ftobler/bldc-high-current/pcb/bldc-high-current-2-easyeda/release/BOM_Board1_PCB1_2025-11-01.xlsx

No. | Quantity | Comment | Designator | Footprint | Value | Manufacturer Part | Manufacturer | Supplier Part | Supplier
1 | 5 | 1nF | C4,C43,C116,C117,C126 | C0402 | 1nF | 0402B102K500NT | FH(风华) | C1523 | LCSC
2 | 5 | 10uF | C9,C96,C97,C98,C100 | C1206 | 10uF | CL31A106KBHNNNE | SAMSUNG(三星) | C13585 | LCSC
3 | 2 | 10pF | C46,C47 | C0402 | 10pF | CL05C100JB5NNNC | SAMSUNG(三星) | C32949 | LCSC
4 | 2 | 68pF | C54,C109 | C0603 | 68pF | 0603CG680J500NT | FH(风华) | C1680 | LCSC
5 | 2 | 47uF | C55,C107 | C0805 | 47uF | CL21A476MQYNNNE | SAMSUNG(三星) | C16780 | LCSC
6 | 4 | 470uF | C110,C111,C112,C113 | CAP-SMD_BD10.0-L10.3-W10.3-FD | 470uF | RVT1V471M1010 | HONOR(荣誉) | C3350 | LCSC
7 | 8 | 10uF | C118,C119,C120,C121,C122,C123,C124,C125 | C0805 | 10uF | CL21A106KAYNNNE | SAMSUNG(三星) | C15850 | LCSC
8 | 23 | 100nF | C137,C138,C139,C143,C144,C145,C146,C147,C148,C151,C152,C153,C154,C155,C156,C157,C158,C159,C160,C161,C162,C163,C164 | C0402 | 100nF | CL05B104KB54PNC | SAMSUNG(三星) | C307331 | LCSC
9 | 1 | SMBJ24CA | D1 | SMB_L4.6-W3.6-LS5.3-BI |  | SMBJ24CA | Brightking(君耀电子) | C78416 | LCSC
10 | 5 | SS14 | D3,D4,D5,D6,D7 | SMA_L4.2-W2.6-LS5.0-RD_1 |  | SS14 | MDD(辰达半导体) | C2480 | LCSC
11 | 5 | T34080080-0680 | J1,J2,J3,J4,J5 | CONN-TH_T34080080-0680 |  | T34080080-0680 | XFCN(兴飞) | C19724524 | LCSC
12 | 2 | B3B-XH-AM-BK(LF)(SN) | J6,J7 | CONN-TH_B3B-XH-AM-BK-LF-SN |  | B3B-XH-AM-BK(LF)(SN) | JST | C565985 | LCSC
13 | 1 | 12uH | L1 | IND-SMD_L6.0-W6.0_SWPA6045S | 12uH | SWPA6045S120MT | Sunlord(顺络) | C96951 | LCSC
14 | 1 | 6.8uH | L2 | IND-SMD_L5.0-W5.0_SWPA5040S | 6.8uH | SWPA5040S6R8MT | Sunlord(顺络) | C36411 | LCSC
15 | 18 | KT-0603R | LED1,LED2,LED3,LED4,LED5,LED6,LED7,LED8,LED9,LED10,LED11,LED12,LED13,LED14,LED15,LED16,LED17,LED18 | LED0603-RD |  | KT-0603R | KENTO | C2286 | LCSC
16 | 7 | DOD100N04 | Q1,Q2,Q7,Q8,Q9,Q10,Q12 | TO-252-2_L6.6-W6.2-P4.57-LS10.1-BR-CW |  | DOD100N04 | DOINGTER(杜因特) | C42374600 | LCSC
17 | 3 | 2mΩ | R1,R47,R54 | RES-SMD_L6.4-W3.2-1 | 2mΩ | HoLLR2512-3W-2mR-1% | Milliohm(毫欧) | C2994640 | LCSC
18 | 6 | 100kΩ | R5,R6,R44,R45,R51,R52 | R0603 | 100kΩ | 0603WAF1003T5E | UNI-ROYAL(厚声) | C25803 | LCSC
19 | 2 | 2.7kΩ | R31,R91 | R0603 | 2.7kΩ | 0603WAF2701T5E | UNI-ROYAL(厚声) | C13167 | LCSC
20 | 2 | 51kΩ | R39,R92 | R0402 | 51kΩ | 0402WGF5102TCE | UNI-ROYAL(厚声) | C25794 | LCSC
21 | 2 | 10Ω | R69,R70 | RES-TH_BD8.0-L24.5-P28.50-D0.8 | 10Ω | KNP5W-10Ω±5% T | CCO(千志电子) | C136506 | LCSC
22 | 7 | 20Ω | R71,R72,R73,R74,R75,R76,R77 | R0805 | 20Ω | 0805W8F200JT5E | UNI-ROYAL(厚声) | C17544 | LCSC
23 | 5 | 15kΩ | R80,R99,R100,R101,R116 | R0402 | 15kΩ | 0402WGF1502TCE | UNI-ROYAL(厚声) | C25756 | LCSC
24 | 37 | 3.3kΩ | R81,R85,R86,R87,R88,R89,R90,R93,R94,R95,R96,R97,R98,R102,R103,R104,R105,R106,R107,R108,R109,R110,R111,R112,R113,R114,R115,R117,R118,R119,R120,R121,R122,R123,R124,R125,R126 | R0402 | 3.3kΩ | 0402WGF3301TCE | UNI-ROYAL(厚声) | C25890 | LCSC
25 | 3 | 10MΩ | R82,R83,R84 | R0603 | 10MΩ | 0603WAF1005T5E | UNI-ROYAL(厚声) | C7250 | LCSC
26 | 3 | TLV9061IDBVR | U2,U23,U26 | SOT-23-5_L3.0-W1.7-P0.95-LS2.8-BL |  | TLV9061IDBVR | TI(德州仪器) | C398358 | LCSC
27 | 1 | AS5600-ASOM | U5 | SOIC-8_L5.0-W4.0-P1.27-LS6.0-BL |  | AS5600-ASOM | ams(艾迈斯半导体) | C79815 | LCSC
28 | 2 | SP3485EN-L/TR | U6,U7 | SOIC-8_L5.0-W4.0-P1.27-LS6.0-BL |  | SP3485EN-L/TR | MaxLinear(迈凌) | C8963 | LCSC
29 | 2 | TPS54302DDCT | U12,U29 | TSOT-23-6_L2.9-W1.6-P0.95-LS2.8-BR |  | TPS54302DDCT | TI(德州仪器) | C129370 | LCSC
30 | 1 | STM32G474RBT6 | U15 | LQFP-64_L10.0-W10.0-P0.50-LS12.0-BL |  | STM32G474RBT6 | ST(意法半导体) | C529413 | LCSC
31 | 1 | M24C64-RMN6TP | U16 | SOIC-8_L5.0-W4.0-P1.27-LS6.0-BL |  | M24C64-RMN6TP | ST(意法半导体) | C79988 | LCSC
32 | 4 | LKS523 | U20,U22,U25,U28 | SOP-8_L4.9-W3.9-P1.27-LS6.0-BL |  | LKS523 | LINKOSEMI(凌鸥创芯) | C6337451 | LCSC
33 | 1 | 25MHz | X1 | CRYSTAL-SMD_4P-L3.2-W2.5-BL | 25MHz | X322525MOB4SI | YXC(扬兴晶振) | C9006 | LCSC
