ftobler/bldc-high-current/pcb/bldc-high-current-2-easyeda/bldc-high-current-2-easyeda.pdf

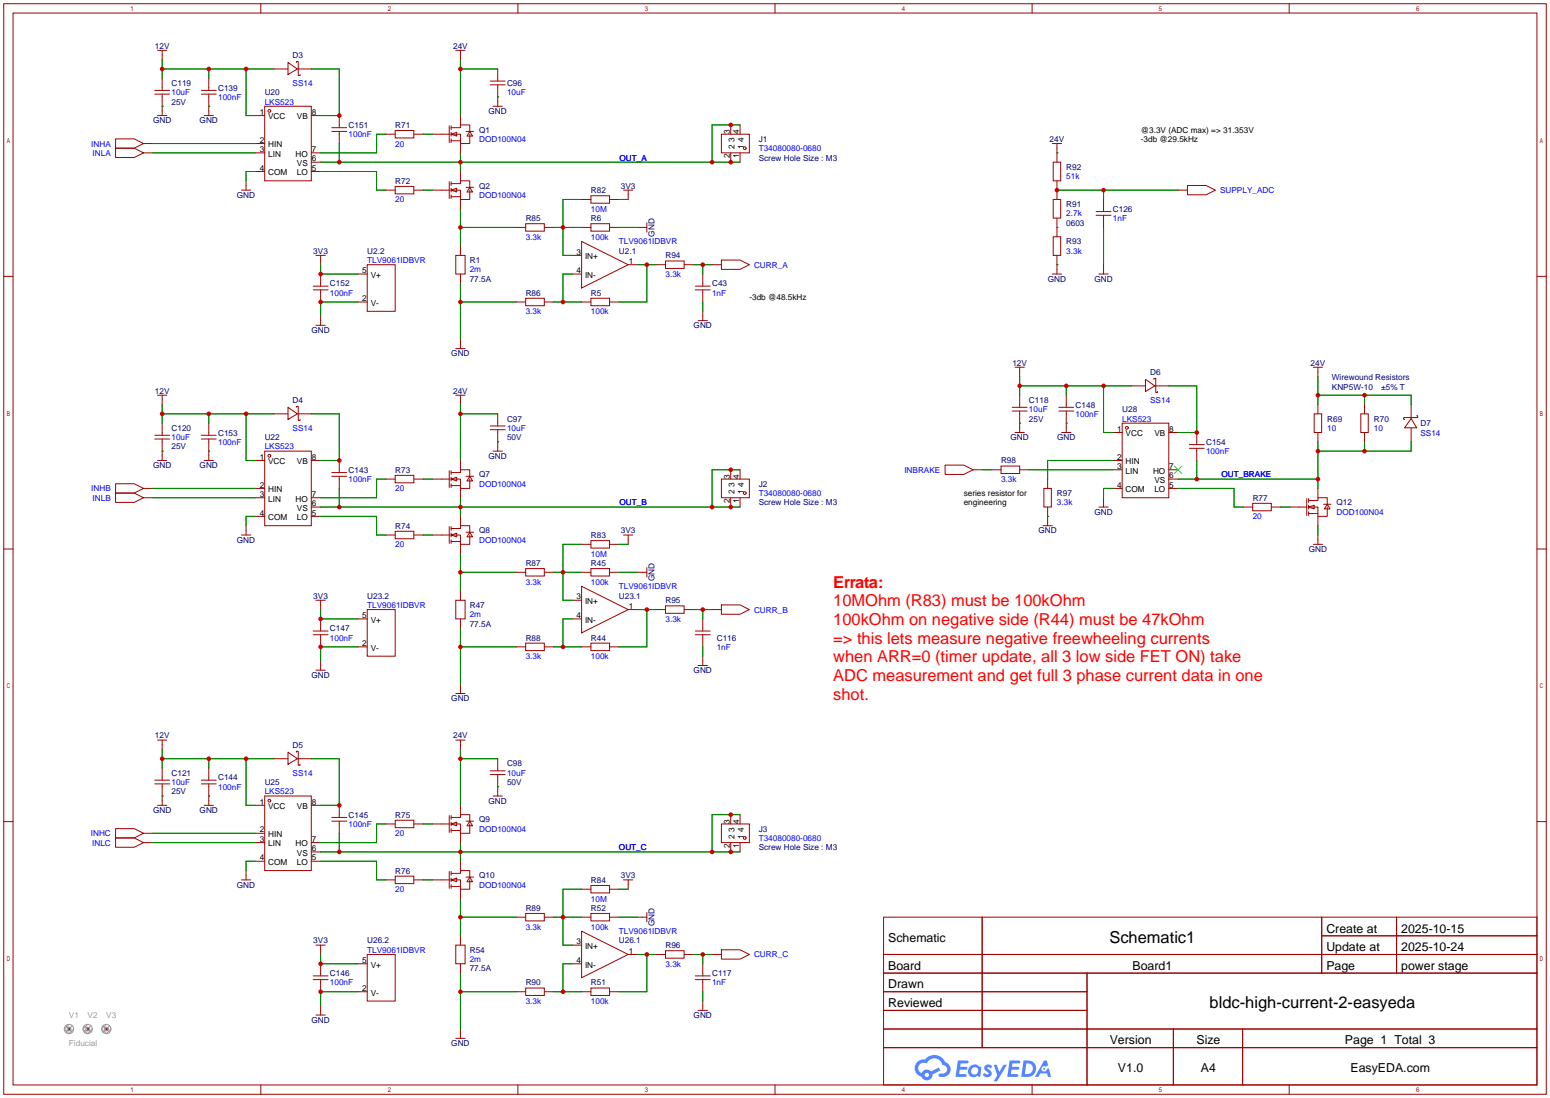
[picture p1: page 1]

Errata:
10MOhm (R83) must be 100kOhm
100kOhm on negative side (R44) must be 47kOhm
=> this lets measure negative freewheeling currents
when ARR=0 (timer update, all 3 low side FET ON) take
ADC measurement and get full 3 phase current data in one
shot.

Schematic | Schematic1 | Create at | 2025-10-15

Update at | 2025-10-24

Board | Board1 | Page | power stage
Drawn | | bldc-high-current-2-easyeda
Reviewed

Version | Size | Page 1 Total 3
V1.0 | A4 | EasyEDA.com

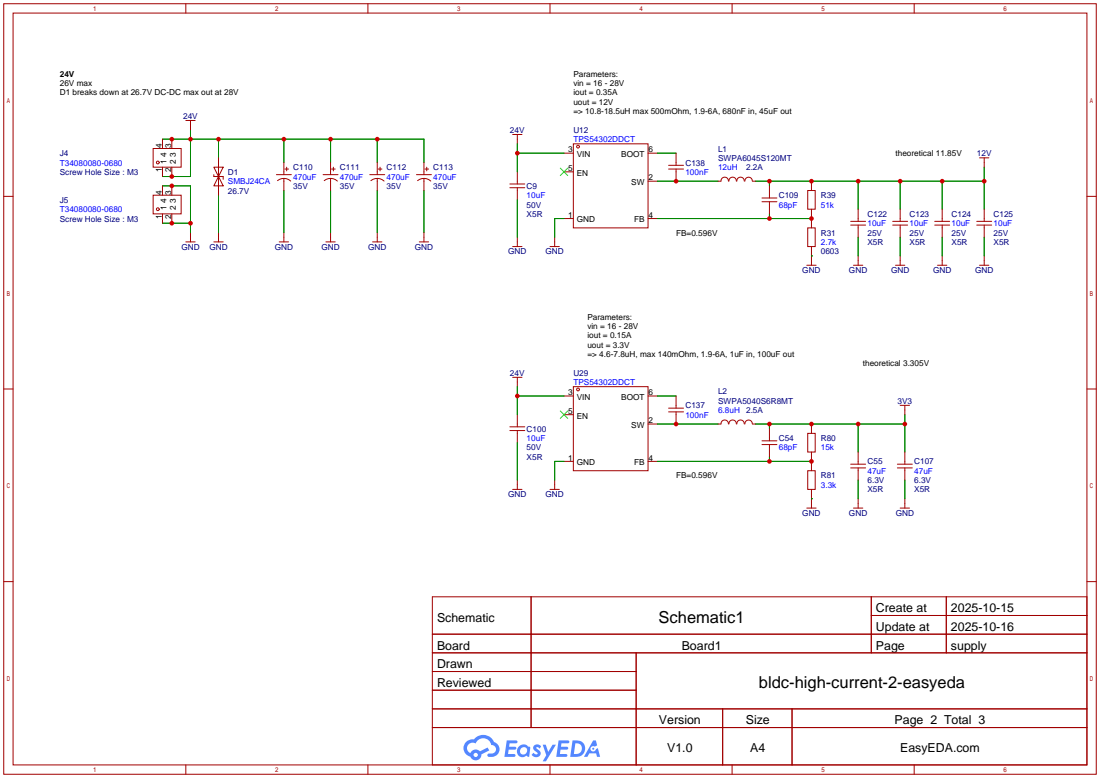
[picture p2: page 2]

26V max
D1 breaks down at 26.7V DC-DC max out at 28V

Schematic | Schematic1 | Create at | 2025-10-15

Update at | 2025-10-16

Board | Board1 | Page | supply
Drawn | | bldc-high-current-2-easyeda
Reviewed

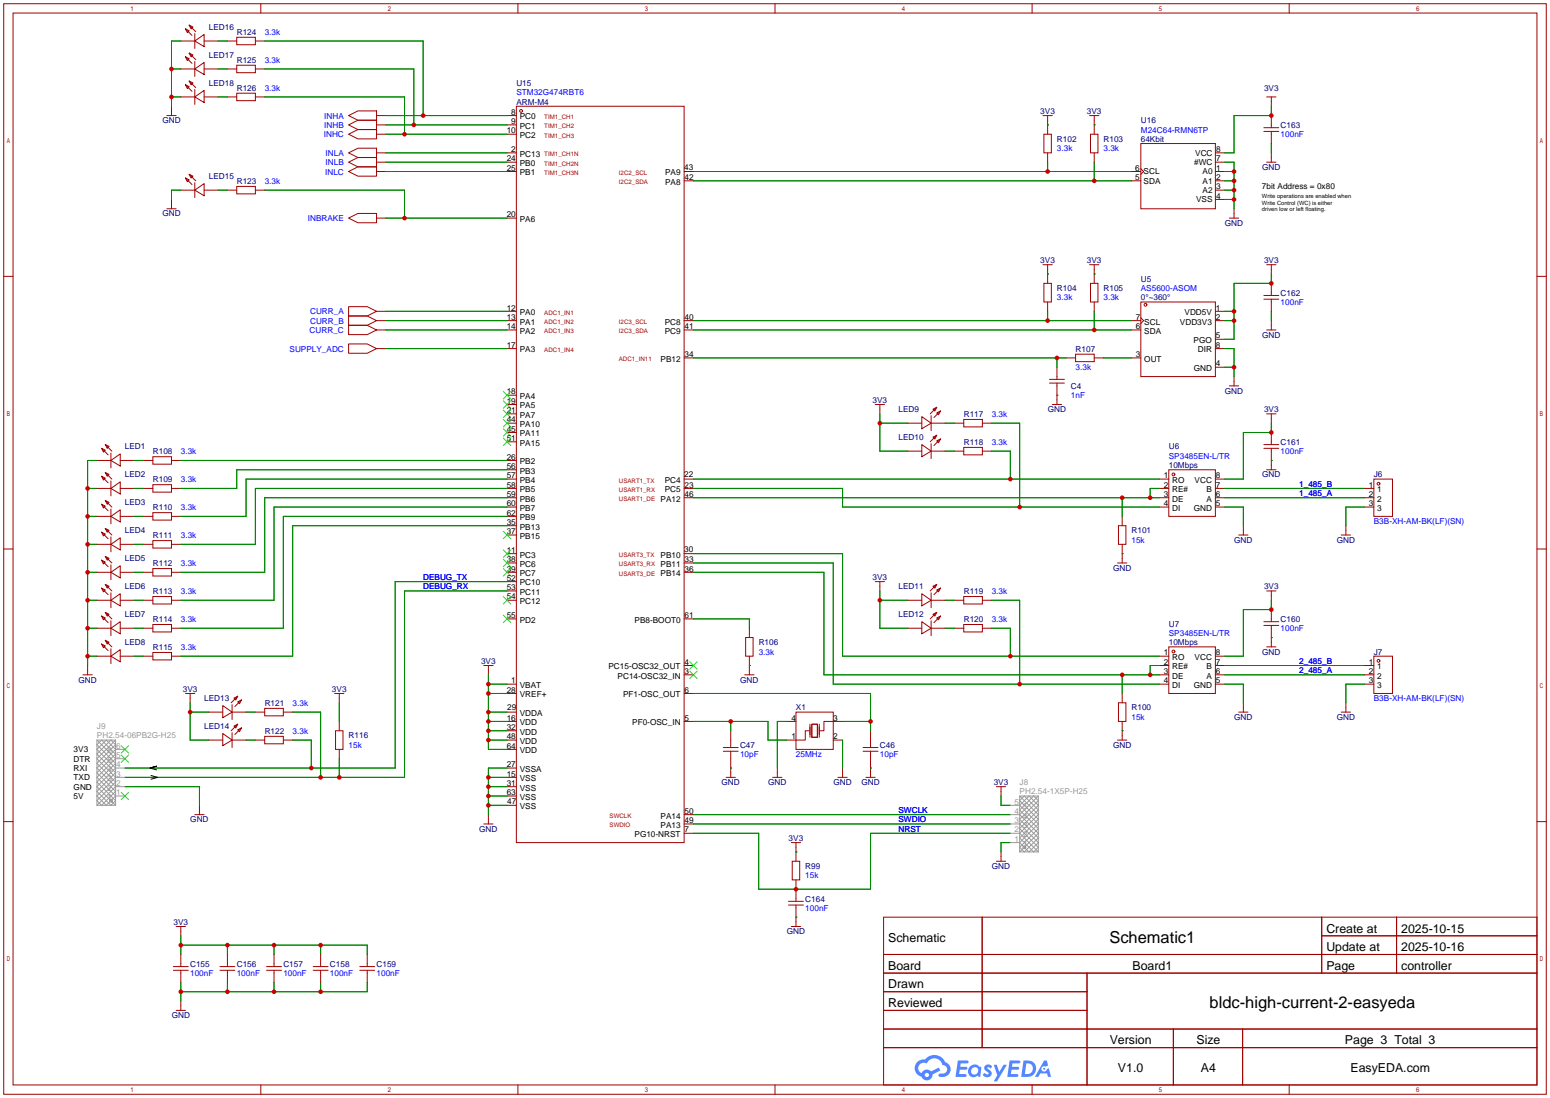
[picture p3: page 3]

GND
7bit Address = 0x80
Write operations are enabled when
Write Control (WC) is either
driven low or left floating.

Schematic | Schematic1 | Create at | 2025-10-15

Update at | 2025-10-16

Board | Board1 | Page | controller
Drawn | | bldc-high-current-2-easyeda
Reviewed
