ftobler/bldc-high-current/(list of files, drawings)

Other design files:
pcb/bldc-high-current-2-easyeda/bldc-high-current-2-easyeda.epro
