ftobler/bldc-high-current/stm-bldc-high-current/stm-bldc-high-current.ioc

Mcu.UserName=STM32G474RBTx
PA0.Signal=ADC1_IN1
PA1.Signal=ADC1_IN2
PA12.Signal=USART1_DE
PA13.Signal=SYS_JTMS-SWDIO
PA14.Signal=SYS_JTCK-SWCLK
PA2.Signal=ADC1_IN3
PA3.Signal=ADC1_IN4
PA6.Signal=S_TIM3_CH1
PA8.Signal=I2C2_SDA
PA9.Signal=I2C2_SCL
PB0.Signal=TIM1_CH2N
PB1.Signal=TIM1_CH3N
PB10.Signal=USART3_TX
PB11.Signal=USART3_RX
PB12.Signal=ADC1_IN11
PB13.GPIO_Label=LED8
PB13.Signal=GPIO_Output
PB14.Signal=USART3_DE
PB2.GPIO_Label=LED1
PB2.Signal=GPIO_Output
PB3.GPIO_Label=LED2
PB3.Signal=GPIO_Output
PB4.GPIO_Label=LED3
PB4.Signal=GPIO_Output
PB5.GPIO_Label=LED4
PB5.Signal=GPIO_Output
PB6.GPIO_Label=LED5
PB6.Signal=GPIO_Output
PB7.GPIO_Label=LED6
PB7.Signal=GPIO_Output
PB9.GPIO_Label=LED7
PB9.Signal=GPIO_Output
PC0.Signal=S_TIM1_CH1
PC1.Signal=S_TIM1_CH2
PC10.Signal=UART4_TX
PC11.Signal=UART4_RX
PC13.Signal=TIM1_CH1N
PC2.Signal=S_TIM1_CH3
PC4.Signal=USART1_TX
PC5.Signal=USART1_RX
PC8.Signal=I2C3_SCL
PC9.Signal=I2C3_SDA
PF0-OSC_IN.Signal=RCC_OSC_IN
PF1-OSC_OUT.Signal=RCC_OSC_OUT
