ftobler/bldc-high-current/stm-bldc-high-current/Core/Inc/main.h

#define LED1_Pin GPIO_PIN_2
#define LED1_GPIO_Port GPIOB
#define LED8_Pin GPIO_PIN_13
#define LED8_GPIO_Port GPIOB
#define LED2_Pin GPIO_PIN_3
#define LED2_GPIO_Port GPIOB
#define LED3_Pin GPIO_PIN_4
#define LED3_GPIO_Port GPIOB
#define LED4_Pin GPIO_PIN_5
#define LED4_GPIO_Port GPIOB
#define LED5_Pin GPIO_PIN_6
#define LED5_GPIO_Port GPIOB
#define LED6_Pin GPIO_PIN_7
#define LED6_GPIO_Port GPIOB
#define LED7_Pin GPIO_PIN_9
#define LED7_GPIO_Port GPIOB
