ftobler/bldc-high-current/stm-bldc-high-current/application/motor.h

/*
 * bldc.h
 *
 *  Created on: Nov 1, 2025
 *      Author: ftobler
 */

#pragma once

#include "stm32_hal.h"
#include "calibration.h"
#include "foc.h"
//#include "speed_control.h"
//#include "position_control.h"
#include "controller.h"
#include "speedometer.h"
#include "shaper.h"
#include "lqi.h"


 struct  __attribute__((packed)) Adc_dma {
    uint16_t current_a;
    uint16_t current_b;
    uint16_t current_c;
    uint16_t supply;
};

static_assert(sizeof(Adc_dma) == 8);  // if false, compiler is set up wrong


class Motor {
private:
    enum class Mode : uint8_t {
        off,               // safe off
        manual,            // direct set of angle/power from user or debug
        calibration,       // static PWM stepping for encoder alignment
        power_control,     // sets angle automatic +90deg or -90deg
        current_control,   // inner FOC or current loop active
        speed_control,     // speed control on top of foc
        position_control,  // positoin control on top of speed
        shaped_position,   // positoin control with slope limit
        lqi_position       // LQI (Linear Quadratic Integrator)
    };
    enum class StopReason {
        none,
        pwm,
        current,
        success,
    };

    static constexpr uint32_t timer_psc = 0;
    static constexpr uint32_t mcu_frequency = 170000000;
    static constexpr uint32_t pwm_frequency = 25000;
    static constexpr uint32_t timer_arr = mcu_frequency / pwm_frequency / 2;  // div 2 is because we are using center aligned mode

    static constexpr int pole_pairs = 5;

    TIM_HandleTypeDef& timer;
    ADC_HandleTypeDef& adc;
    Adc_dma adc_buffer = {0};

    // at startup, the first sample is to calibrate 0A point
    int16_t current_a_zero_offset = 0;
    int16_t current_b_zero_offset = 0;
    int16_t current_c_zero_offset = 0;

    // runtime control variables
    bool pwm_on = false;
    float power = 0.0f;
    float angle = 0.0f;
    float angle_increment = 0.0f;
    Mode state = Mode::off;
    Mode old_state = Mode::off;
    StopReason stop_reason = StopReason::none;

    // calculated phase currents
    float current_a = 0.0f;
    float current_b = 0.0f;
    float current_c = 0.0f;
    float supply_voltage = 0.0f;

    float current_a_tpfilter = 0.0f;
    float current_b_tpfilter = 0.0f;
    float current_c_tpfilter = 0.0f;
    int32_t encoder_value = 0;  // current angle 12bit
    int32_t encoder_offset = 2043;  // from a calibration

    Calibration calibration;
    Foc foc;
    Speedometer speedometer;
    Controller speed;
    Controller position;
    Shaper shaper;
    LqiController lqi;

//    Speed speed;
//    Position position;

    inline void assign_pwm(float power, float angle);
    inline void assign_pwm_volt(float sa, float sb, float sc);
    inline void assign_stop();
    inline void setup_timer();
    inline void setup_adc();
    inline float calculate_supply_voltage(uint16_t sample);
    inline float calculate_adc_current(int16_t sample);
    inline void adc_calculate();
    inline void current_kirchhoff_reconstruct(float a, float b, float c);
    inline void calibrate_adc();
    inline void run_calibration_step();
    inline void run_power_control();
    inline void run_current_control();
    inline void run_speed_control();
    inline void run_position_control();
    inline void run_position_shaped_control();
    inline void run_lqi_control();
    inline void pwm_safe_assign(Vector3& v);

    static constexpr float update_time = 1 / 24000.0f;
public:
    Motor(
            TIM_HandleTypeDef& timer,
            ADC_HandleTypeDef& adc
    ):
        timer(timer),
        adc(adc),
        speedometer(update_time),
        // position(0.0075f, 0.000, 1.0f, +15.0f, -15.0f, update_time) {};
        speed(4.0f, 100.0f, 1.0f, 35.0f, -35.0f, update_time),
        position(30.0f, 0.0f, 0.0f, +20.0f, -20.0f, update_time),
        shaper(12.0f, 100.0f, update_time),  // practical max is 2.5*240000
//        lqi(100.0f, 5.0f, 5000.0f, update_time, 35.0f) {};  // for PoE
        lqi(150.0f, 5.0f, 8000.0f, update_time, 35.0f) {};  // for PoM

    /**
     * called once at startup
     * needs to start ADC in continious DMA mode
     * needs to start pwm timer
     */
    void init();

    /**
     * timer update isr calls this
     * it's time to re-calculate the currents from last ADC capture
     */
    void timer_isr();
    void set_angle(int32_t angle_value) {
        // angle is expressed as 0..4095 being 2 pi. that is motor shaft rotation and not pole rotation
        encoder_value = angle_value;
    }

    inline float get_supply_voltage() { return supply_voltage; }
    inline float get_current_a() { return current_a; }
    inline float get_current_b() { return current_b; }
    inline float get_current_c() { return current_c; }
//    inline void set_mode(Mode m) { state = m; }
//    inline Mode get_mode() const { return state; }
};
