ftobler/bldc-high-current/(commit log)

2025-11-01 pcb data as ordered from jlcpcb
    [BOM_Board1_PCB1_2025-11-01.xlsx, PickAndPlace_PCB1_2025-11-01.xlsx, bldc-high-current-2-easyeda.epro]
2025-11-01 fresh stm32 cube project
2025-11-01 pwm, dead time, adc setup and measurements
2025-11-02 timer and adc setup
2025-11-02 rename stm32 project
2025-11-02 renamc pcb
    [BOM_Board1_PCB1_2025-11-01.xlsx, PickAndPlace_PCB1_2025-11-01.xlsx, bldc-high-current-2-easyeda.epro]
2025-11-02 encoder read
2025-11-02 feed encoder into motor
2025-11-02 calibration and manual power control with +90deg voltage field
2025-11-02 foc first motor turn
2025-11-02 bugfix in FOC, startup
    [foc.cpp, foc.h, motor.cpp]
2025-11-04 show current on leds
2025-11-04 foc without filtered values, kirchhoff reconstruct. currently one phase measurement is bad
2025-11-09 init position with current position to avoid motor turning when loop activates
    [motor.cpp]
