ftobler/bldc-high-current/(notices)

Notices in the files:
stm-bldc-high-current/Core/Inc/main.h:
Copyright (c) 2025 STMicroelectronics.
All rights reserved.
This software is licensed under terms that can be found in the LICENSE file
